maulmaolmawl/BQ76920_ActiveBal/MAIN_BQ_INDUCTOR_REV/Board.png

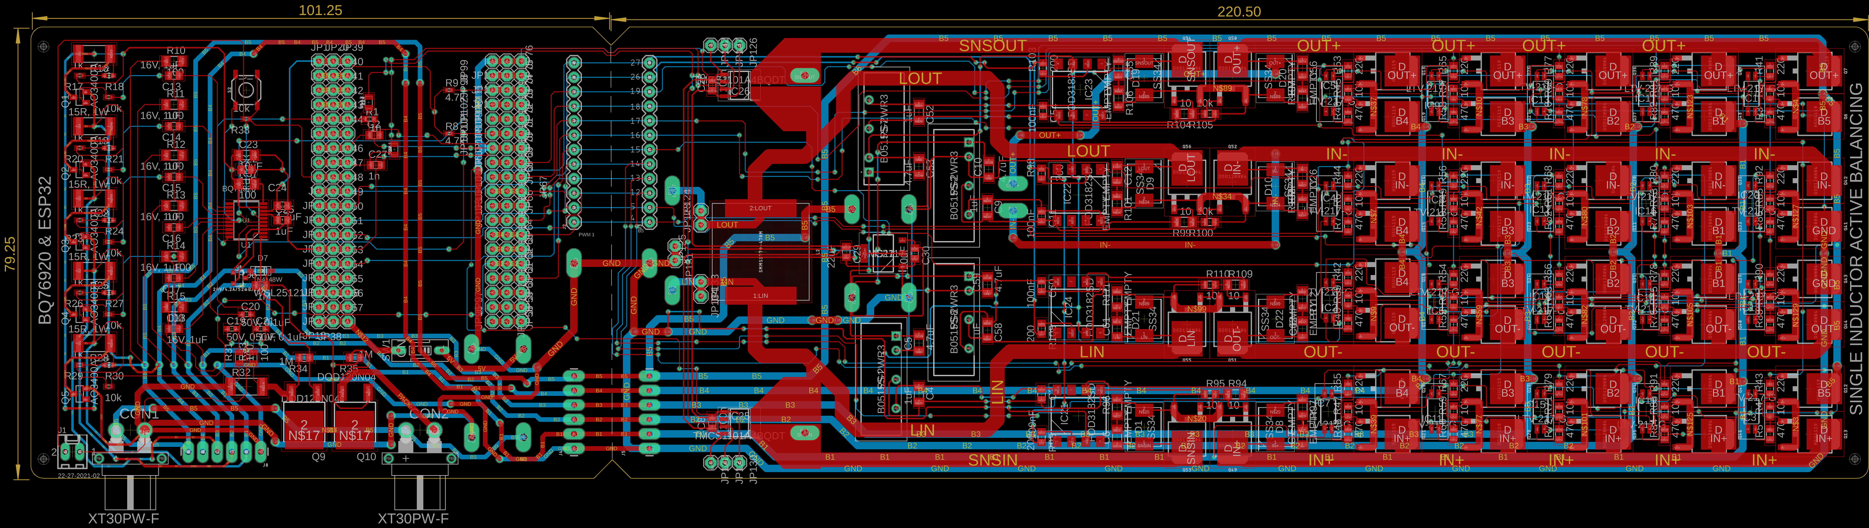
MAIN_BQ_INDUCTOR_REV/Board.png
