maulmaolmawl/BQ76920_ActiveBal/MAIN_BQ_INDUCTOR_REV/Skema.png

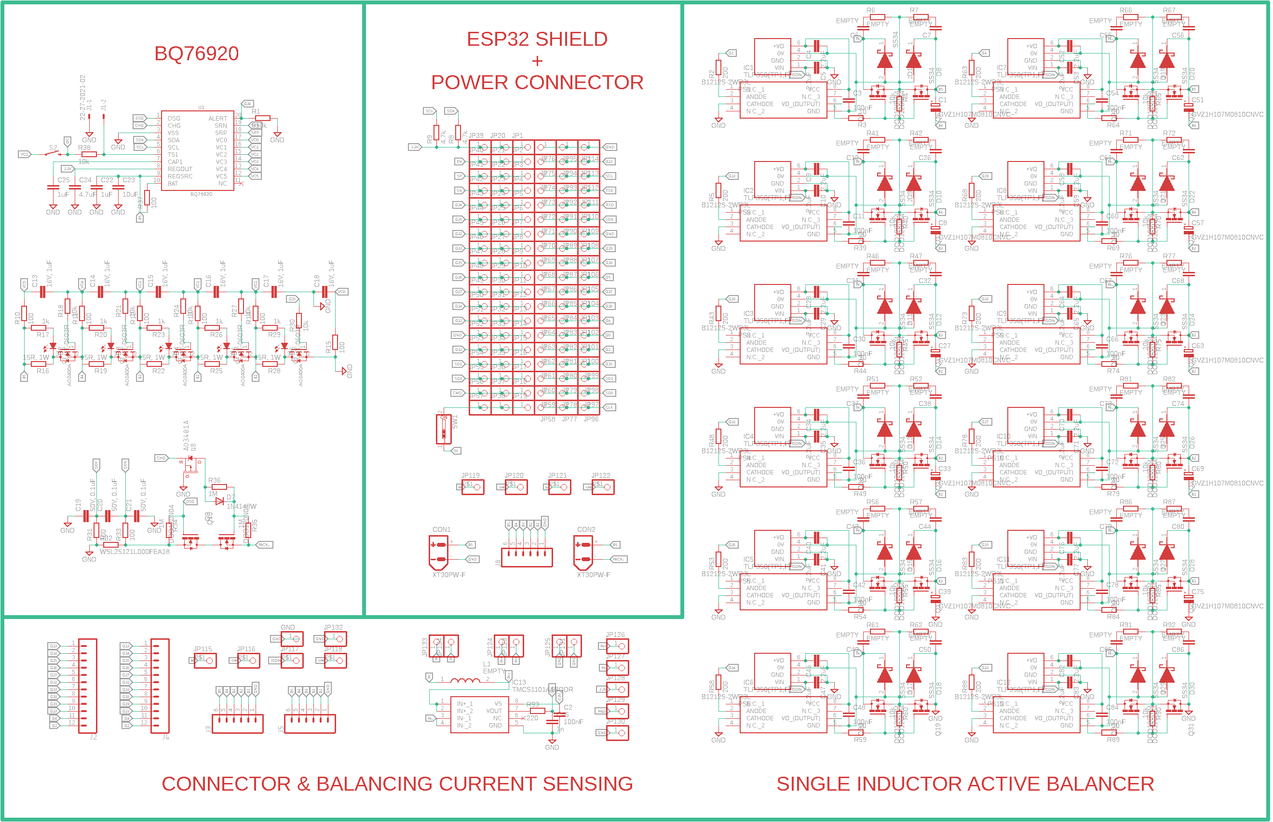
MAIN_BQ_INDUCTOR_REV/Skema.png
