maulmaolmawl/BQ76920_ActiveBal/MAIN_BQ_INDUCTOR_REV/Skematik2.png

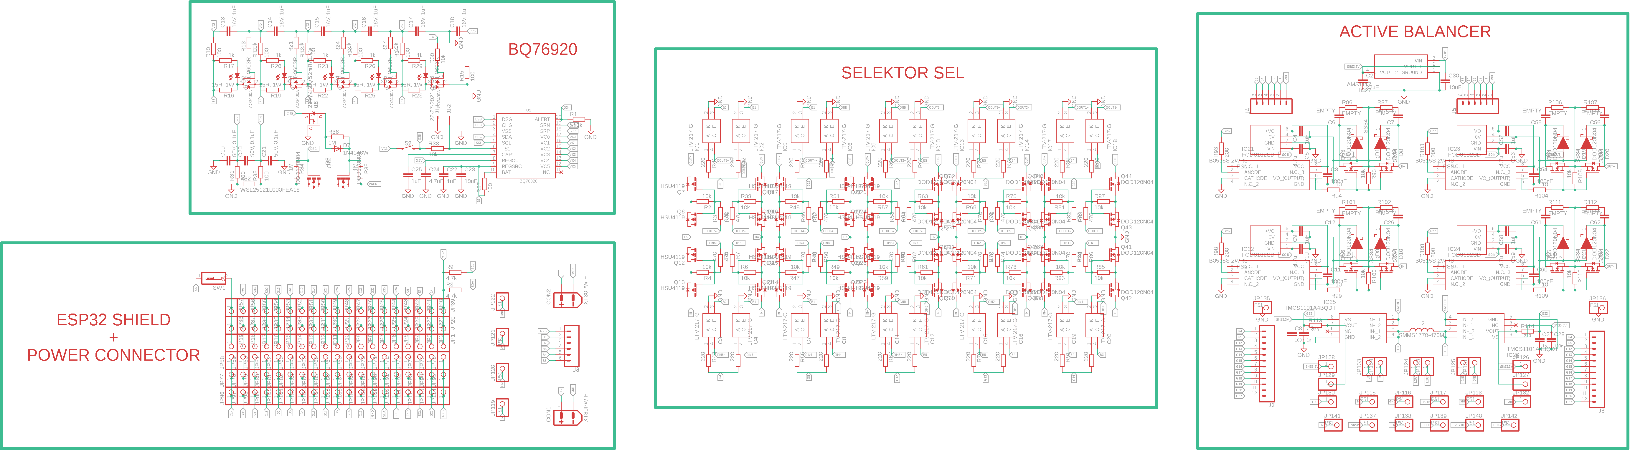
MAIN_BQ_INDUCTOR_REV/Skematik2.png
