maulmaolmawl/BQ76920_ActiveBal/MAIN_BQ_INDUCTOR_REV/Skematikk.png

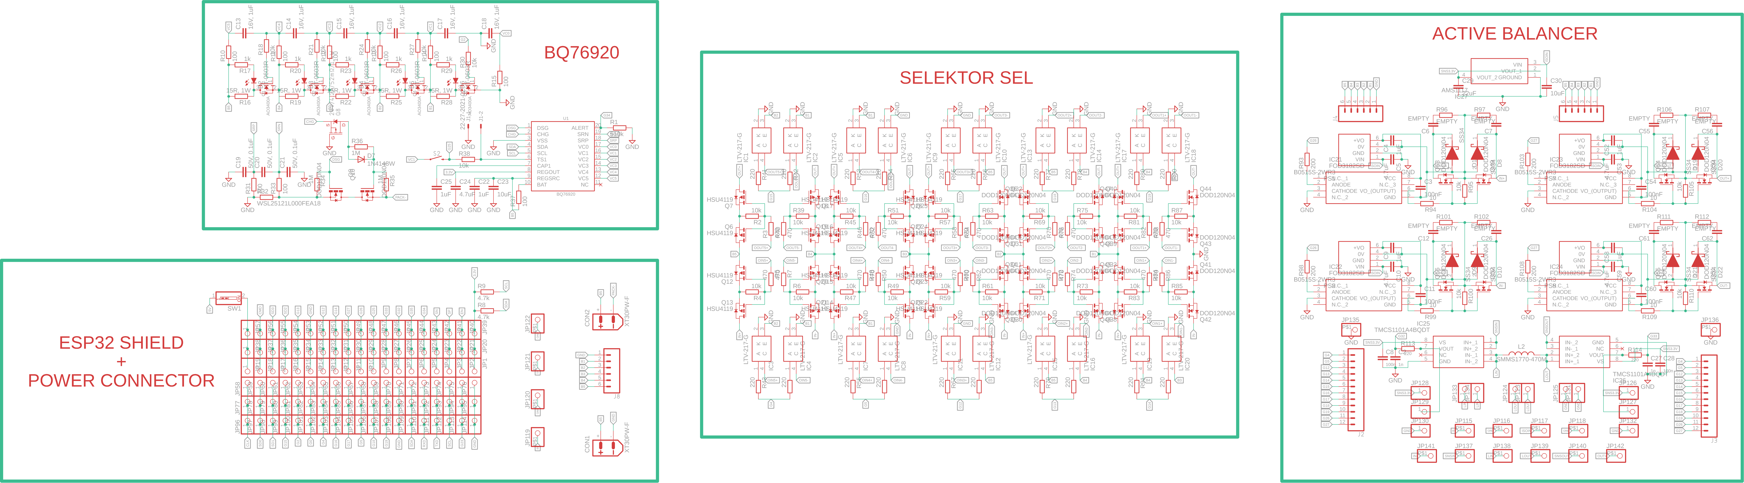
MAIN_BQ_INDUCTOR_REV/Skematikk.png
