maulmaolmawl/BQ76920_ActiveBal/MAIN_BQ_INDUCTOR_REV/MAIN_BQ_INDUCTOR_REV.brd

## EAGLE design MAIN_BQ_INDUCTOR_REV/MAIN_BQ_INDUCTOR_REV.brd (2026-06-24)

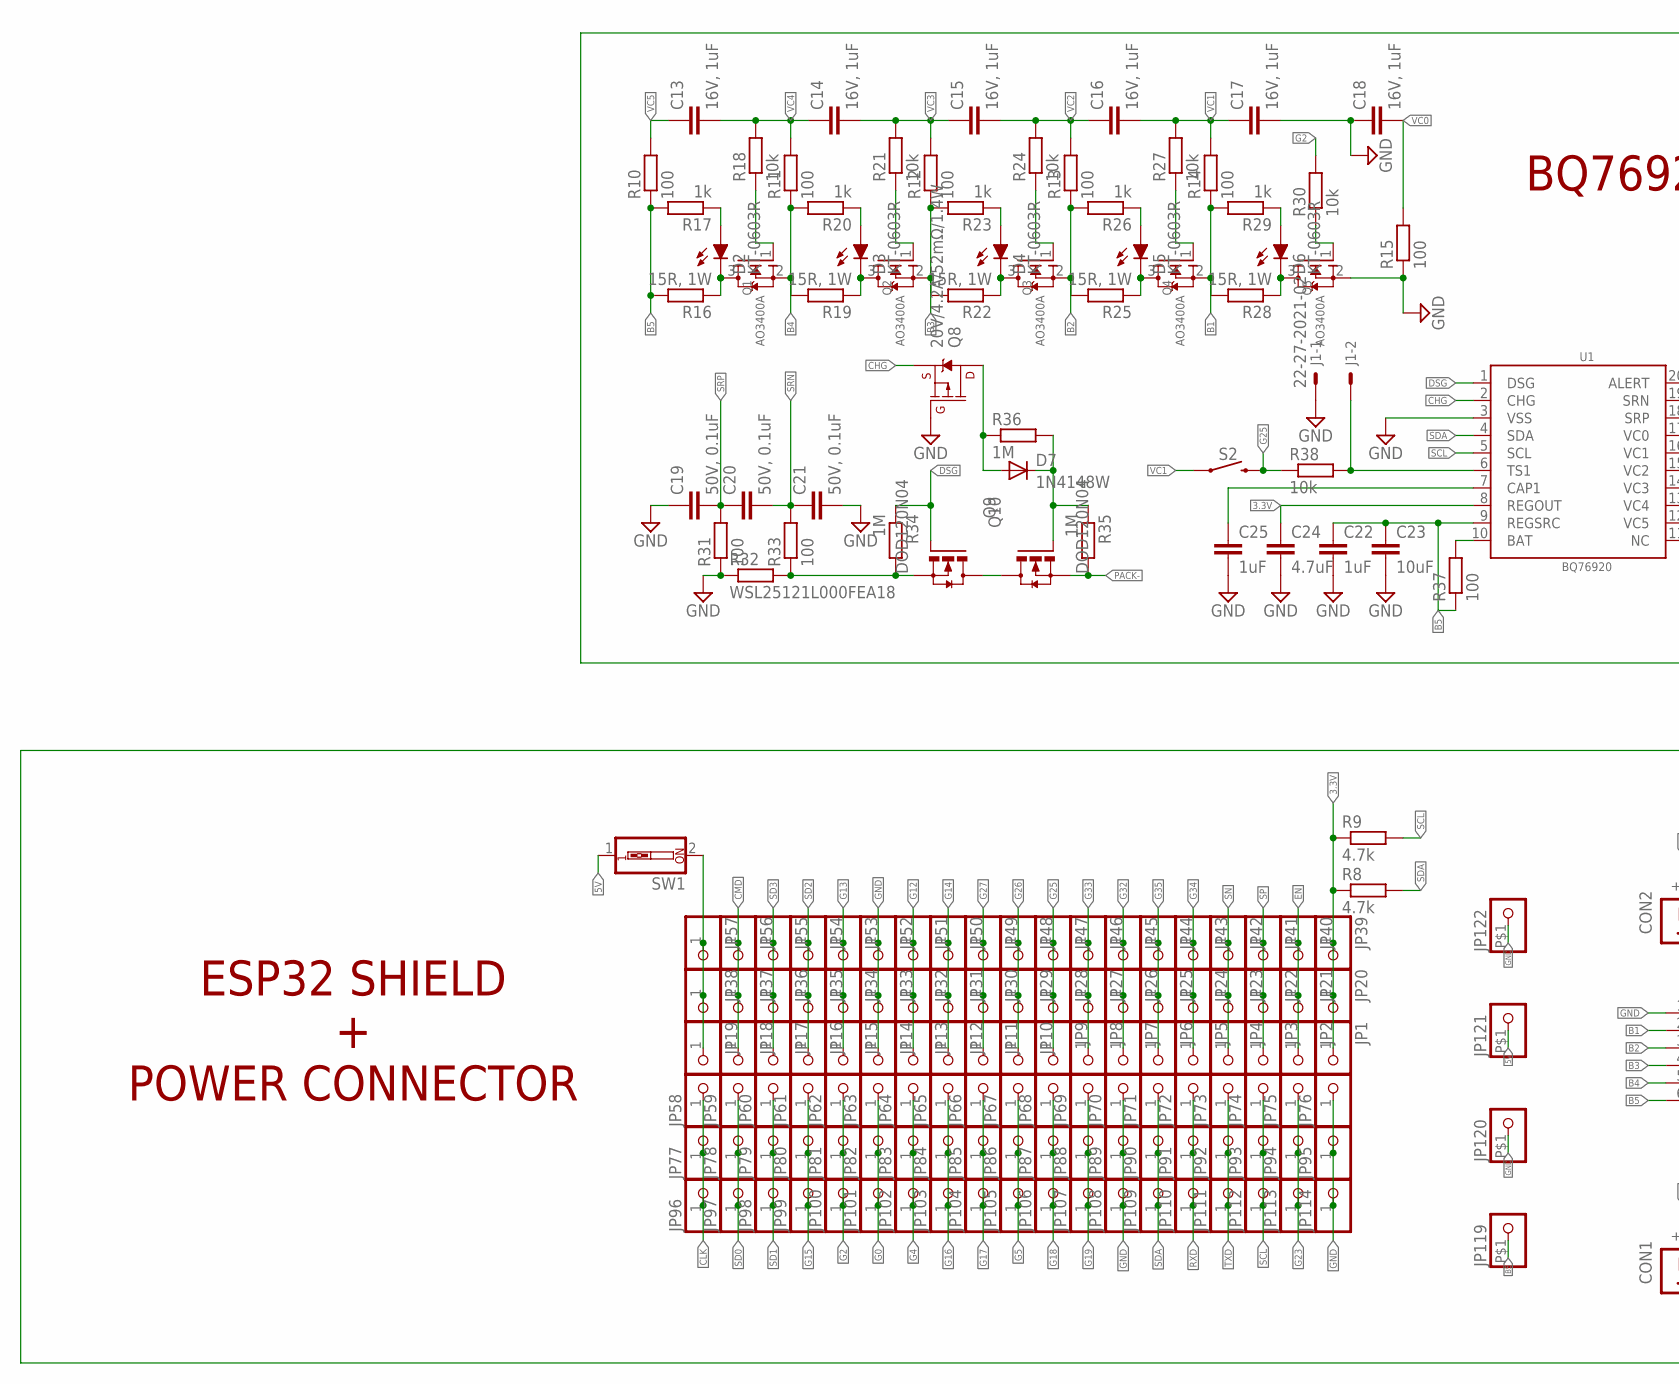
[picture p5: schematic MAIN_BQ_INDUCTOR_REV.sch, part in row 1, column 1]

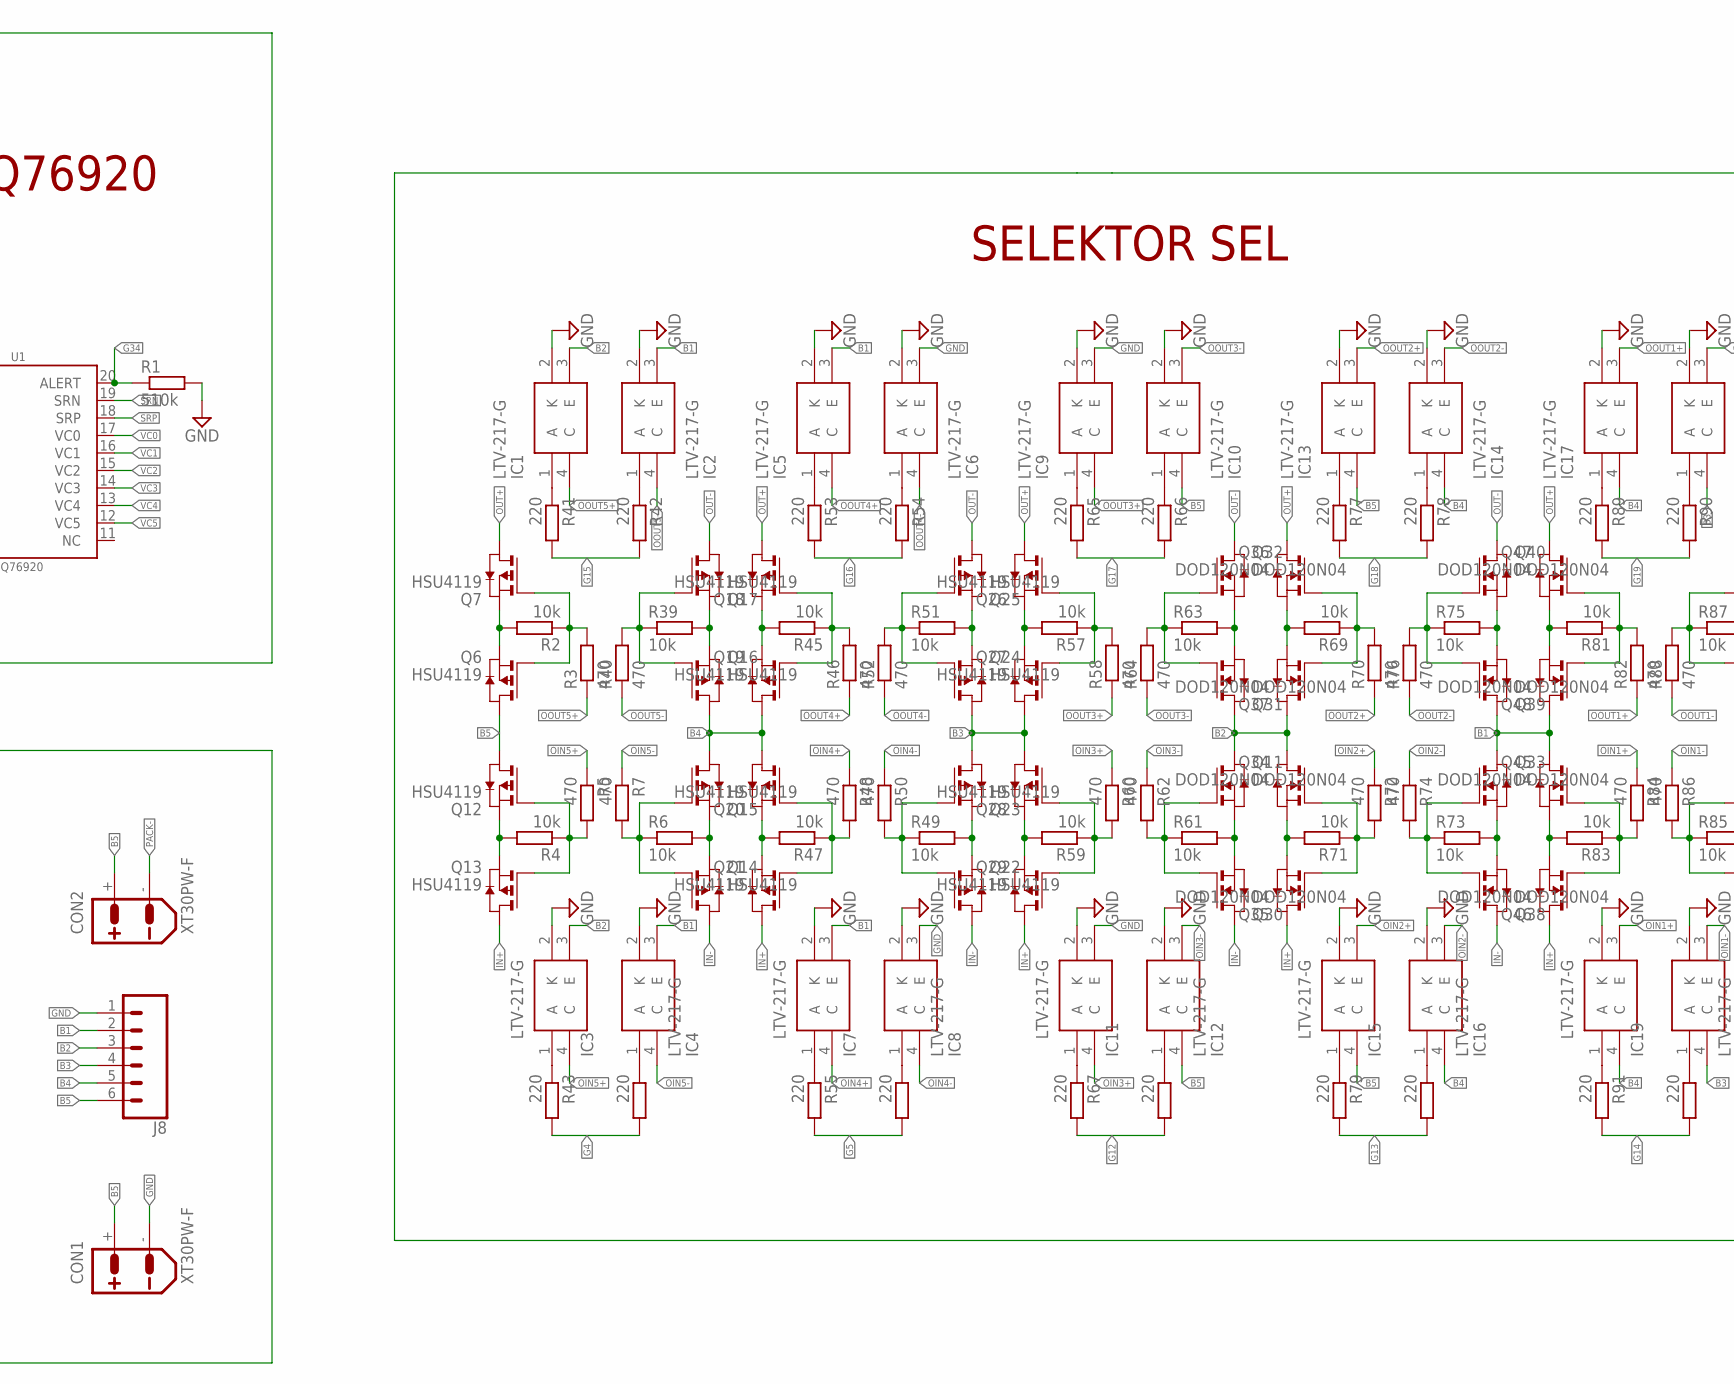
[picture p6: schematic MAIN_BQ_INDUCTOR_REV.sch, part in row 1, column 2]

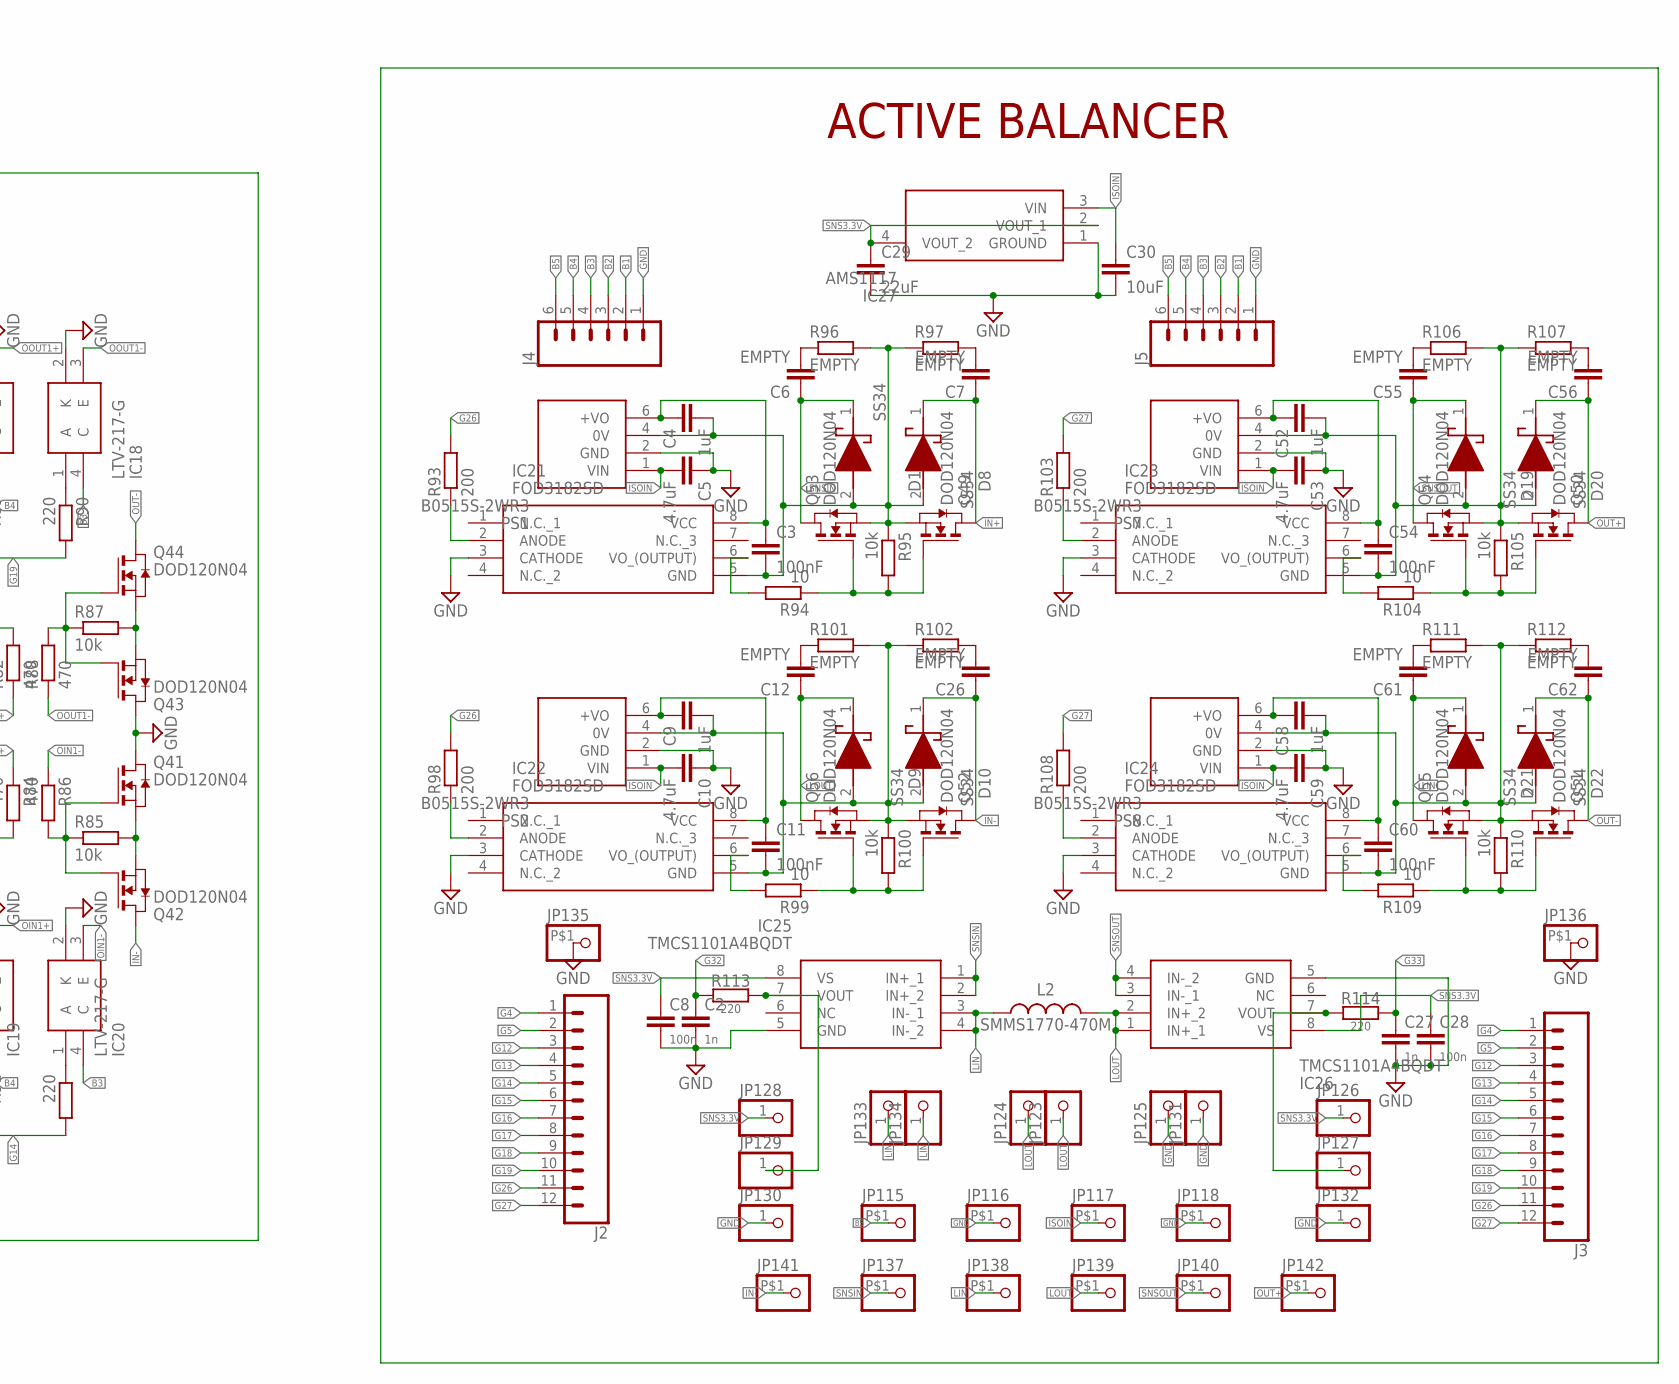
[picture p7: schematic MAIN_BQ_INDUCTOR_REV.sch, part in row 1, column 3]

Parts:
C2, C27: 1n; C0805
C3, C11, C54, C60: 100nF; C0805
C4, C9, C52, C58: 1uF; C1206
C5, C10, C53, C59: 4.7uF; C1206
C6, C7, C12, C26, C55, C56, C61, C62: EMPTY; C1206
C8, C28: 100n; C0805
C13, C14, C15, C16, C17, C18: 16V, 1uF; C0805
C19, C20, C21: 50V, 0.1uF; C0603
C22, C25: 1uF; C0805
C23: 10uF; C1206
C24: 4.7uF; C0805
C29: 22uF; C0805
C30: 10uF; C0805
CON1, CON2: XT30PW-F
D1, D8, D9, D10, D19, D20, D21, D22: SS34; DIOM6959X262N
D2, D3, D4, D5, D6: KT-0603R; LED_CHIP-LED0603MP
D7: 1N4148W; SOD-123
IC1, IC2, IC3, IC4, IC5, IC6, IC7, IC8, IC9, IC10, IC11, IC12, IC13, IC14, IC15, IC16, IC17, IC18, IC19, IC20: LTV-217-G; LTV217G
IC21, IC22, IC23, IC24: FOD3182SD; SOP254P1000X400-8N
IC25, IC26: TMCS1101A4BQDT; SOIC127P600X175-8N
IC27: AMS1117; SOT229P700X180-4N
J1: 22-27-2021-02; 6410-02
J2, J3: CONN_12; 1X12
J4, J5, J8: CONN_06LONGPADS; 1X06_LONGPADS
JP1, JP2, JP3, JP4, JP5, JP6, JP7, JP8, JP9, JP10, JP11, JP12, JP13, JP14, JP15, JP16, JP17, JP18, JP19, JP20, JP21, JP22, JP23, JP24, JP25, JP26, JP27, JP28, JP29, JP30, JP31, JP32, JP33, JP34, JP35, JP36, JP37, JP38, JP39, JP40, JP41, JP42, JP43, JP44, JP45, JP46, JP47, JP48, JP49, JP50, JP51, JP52, JP53, JP54, JP55, JP56, JP57, JP58, JP59, JP60, JP61, JP62, JP63, JP64, JP65, JP66, JP67, JP68, JP69, JP70, JP71, JP72, JP73, JP74, JP75, JP76, JP77, JP78, JP79, JP80, JP81, JP82, JP83, JP84, JP85, JP86, JP87, JP88, JP89, JP90, JP91, JP92, JP93, JP94, JP95, JP96, JP97, JP98, JP99, JP100, JP101, JP102, JP103, JP104, JP105, JP106, JP107, JP108, JP109, JP110, JP111, JP112, JP113, JP114, JP123, JP124, JP125, JP126, JP127, JP128, JP129, JP130, JP131, JP132, JP133, JP134: PINHD-1X1; 1X01
JP115, JP116, JP117, JP118, JP119, JP120, JP121, JP122, JP135, JP136, JP137, JP138, JP139, JP140, JP141, JP142: PINHD-1X1-BIGPOGO; 1X1-BIGPOGO
L2: SMMS1770-470M; PA4344-17X17
PS1, PS2, PS7, PS8: B0515S-2WR3; B1212S2WR3
Q1, Q2, Q3, Q4, Q5: AO3400A; SOT23
Q6, Q7, Q12, Q13, Q14, Q15, Q16, Q17, Q18, Q19, Q20, Q21, Q22, Q23, Q24, Q25, Q26, Q27, Q28, Q29: HSU4119; TO252
Q8: 20V/4.2A/52mΩ/1.4W; SOT23-3
Q9, Q10: DOD120N04; DPAK
Q11, Q30, Q31, Q32, Q33, Q34, Q35, Q36, Q37, Q38, Q39, Q40, Q41, Q42, Q43, Q44, Q45, Q46, Q47, Q48, Q49, Q50, Q51, Q52, Q53, Q54, Q55, Q56: DOD120N04; TO252
R1: 510k; R0603
R2, R4, R6, R39, R45, R47, R49, R51, R57, R59, R61, R63, R69, R71, R73, R75, R81, R83, R85, R87, R95, R100, R105, R110: 10k; R0805
R3, R5, R7, R40, R46, R48, R50, R52, R58, R60, R62, R64, R70, R72, R74, R76, R82, R84, R86, R88: 470; R0805
R8, R9: 4.7k; R0402
R10, R11, R12, R13, R14, R15, R37: 100; R1206
R16, R19, R22, R25, R28: 15R, 1W; R2512
R17, R20, R23, R26, R29: 1k; R0402
R18, R21, R24, R27, R30, R38: 10k; R0402
R31, R33: 100; R0805
R32: WSL25121L000FEA18; R2512
R34, R35, R36: 1M; R0805
R41, R42, R43, R44, R53, R54, R55, R56, R65, R66, R67, R68, R77, R78, R79, R80, R89, R90, R91, R92, R113, R114: 220; R0805
R93, R98, R103, R108: 200; R0805
R94, R99, R104, R109: 10; R1206
R96, R97, R101, R102, R106, R107, R111, R112: EMPTY; R1206
S2: MOMENTARY-SWITCH-SPST-SMD-5.2-TALL-REDUNDANT; TACTILE_SWITCH_SMD_5.2MM
SW1: SW_DIP-1; EDG-01
U1: BQ76920; TSSOP-20_4.4X6.5MM_PITCH0.65MM

Connections:
3.3V: C24.1, JP1.1, JP20.1, JP39.1, R8.1, R9.1, U1.8 (REGOUT)
5V: JP121.P$1, SW1.1
B1: IC2.3 (E), IC4.3 (E), IC5.3 (E), IC7.3 (E), J4.2, J5.2, J8.2, Q4.2 (S), Q33.D, Q39.D, Q45.D, Q48.D, R14.1, R28.2, R29.2
B2: IC1.3 (E), IC3.3 (E), J4.3, J5.3, J8.3, Q3.2 (S), Q11.D, Q31.D, Q34.D, Q37.D, R13.1, R25.2, R26.2
B3: IC18.4 (C), IC20.4 (C), J4.4, J5.4, J8.4, Q2.2 (S), Q23.D, Q24.D, Q27.D, Q28.D, R12.1, R22.2, R23.2
B4: IC14.4 (C), IC16.4 (C), IC17.4 (C), IC19.4 (C), J4.5, J5.5, J8.5, Q1.2 (S), Q15.D, Q16.D, Q19.D, Q20.D, R11.1, R19.2, R20.2
B5: C22.1, C23.1, CON1.+, CON2.+, IC10.4 (C), IC12.4 (C), IC13.4 (C), IC15.4 (C), J4.6, J5.6, J8.6, JP115.P$1, JP119.P$1, Q6.D, Q12.D, R10.1, R16.2, R17.2, R37.1, U1.9 (REGSRC)
CHG: Q8.2 (S), U1.2 (CHG)
CLK: JP58.1, JP77.1, JP96.1
CMD: JP18.1, JP37.1, JP56.1
DSG: Q9.1 (G), R34.1, U1.1 (DSG)
EN: JP2.1, JP21.1, JP40.1
G0: JP63.1, JP82.1, JP101.1
G2: JP62.1, JP81.1, JP100.1, R30.2
G4: J2.1, J3.1, JP64.1, JP83.1, JP102.1, R43.2, R44.2
G5: J2.2, J3.2, JP67.1, JP86.1, JP105.1, R55.2, R56.2
G12: J2.3, J3.3, JP13.1, JP32.1, JP51.1, R67.2, R68.2
G13: J2.4, J3.4, JP15.1, JP34.1, JP53.1, R79.2, R80.2
G14: J2.5, J3.5, JP12.1, JP31.1, JP50.1, R91.2, R92.2
G15: J2.6, J3.6, JP61.1, JP80.1, JP99.1, R41.2, R42.2
G16: J2.7, J3.7, JP65.1, JP84.1, JP103.1, R53.2, R54.2
G17: J2.8, J3.8, JP66.1, JP85.1, JP104.1, R65.2, R66.2
G18: J2.9, J3.9, JP68.1, JP87.1, JP106.1, R77.2, R78.2
G19: J2.10, J3.10, JP69.1, JP88.1, JP107.1, R89.2, R90.2
G23: JP75.1, JP94.1, JP113.1
G25: JP9.1, JP28.1, JP47.1, R38.1, S2.3 (2), S2.4 (2)
G26: J2.11, J3.11, JP10.1, JP29.1, JP48.1, R93.2, R98.2
G27: J2.12, J3.12, JP11.1, JP30.1, JP49.1, R103.2, R108.2
G32: C2.1, JP7.1, JP26.1, JP45.1, R113.1
G33: C27.1, JP8.1, JP27.1, JP46.1, R114.2
G34: JP5.1, JP24.1, JP43.1, R1.1, U1.20 (ALERT)
G35: JP6.1, JP25.1, JP44.1
GND: C2.2, C5.1, C8.2, C10.1, C17.2, C18.1, C19.1, C21.2, C22.2, C23.2, C24.2, C25.2, C27.2, C28.2, C29.2, C30.2, C53.1, C59.1, CON1.-, IC1.2 (K), IC2.2 (K), IC3.2 (K), IC4.2 (K), IC5.2 (K), IC6.2 (K), IC6.3 (E), IC7.2 (K), IC8.2 (K), IC8.3 (E), IC9.2 (K), IC9.3 (E), IC10.2 (K), IC11.2 (K), IC11.3 (E), IC12.2 (K), IC13.2 (K), IC14.2 (K), IC15.2 (K), IC16.2 (K), IC17.2 (K), IC18.2 (K), IC19.2 (K), IC20.2 (K), IC21.3 (CATHODE), IC22.3 (CATHODE), IC23.3 (CATHODE), IC24.3 (CATHODE), IC25.5 (GND), IC26.5 (GND), IC27.1 (GROUND), J1.1, J4.1, J5.1, J8.1, JP14.1, JP33.1, JP52.1, JP70.1, JP76.1, JP89.1, JP95.1, JP108.1, JP114.1, JP116.P$1, JP118.P$1, JP120.P$1, JP122.P$1, JP125.1, JP130.1, JP131.1, JP132.1, JP135.P$1, JP136.P$1, PS1.2 (GND), PS2.2 (GND), PS7.2 (GND), PS8.2 (GND), Q5.2 (S), Q8.1 (G), Q41.D, Q43.D, R1.2, R15.1, R31.1, R32.1, U1.3 (VSS)
IN+: C7.1, D8.1 (K), Q13.D, Q21.D, Q29.D, Q35.D, Q46.D, Q49.D
IN-: C26.1, D10.1 (K), JP141.P$1, Q14.D, Q22.D, Q30.D, Q38.D, Q42.D, Q52.D
ISOIN: C5.2, C10.2, C30.1, C53.2, C59.2, IC27.3 (VIN), JP117.P$1, PS1.1 (VIN), PS2.1 (VIN), PS7.1 (VIN), PS8.1 (VIN)
LIN: C61.1, D21.1 (K), IC25.3 (IN-_1), IC25.4 (IN-_2), JP133.1, JP134.1, JP138.P$1, L2.1, Q55.D
LOUT: C12.1, D9.1 (K), IC26.1 (IN+_1), IC26.2 (IN+_2), JP123.1, JP124.1, JP139.P$1, L2.2, Q56.D
unnamed: Q12.G, Q13.G, R4.1, R5.2
unnamed: Q6.G, Q7.G, R2.1, R3.2
unnamed: Q12.S, Q13.S, R4.2
unnamed: Q6.S, Q7.S, R2.2
unnamed: Q26.G, Q27.G, R57.1, R58.2
unnamed: Q14.G, Q15.G, R6.1, R7.2
unnamed: Q14.S, Q15.S, R6.2
unnamed: Q16.G, Q17.G, R39.1, R40.2
unnamed: Q16.S, Q17.S, R39.2
unnamed: Q26.S, Q27.S, R57.2
unnamed: IC21.6 (VO_(OUTPUT)), R94.2
unnamed: JP19.1, JP38.1, JP57.1, SW1.2
unnamed: D7.A, Q8.3 (D), R36.1
unnamed: Q9.3 (S), R32.2, R33.1, R34.2
unnamed: C3.1, C4.1, IC21.8 (VCC), PS1.6 (+VO)
unnamed: Q9.2 (D), Q10.2 (D)
unnamed: R37.2, U1.10 (BAT)
unnamed: IC21.2 (ANODE), R93.1
unnamed: C3.2, C4.2, D1.2 (A), D8.2 (A), IC21.5 (GND), PS1.4 (0V), Q49.S, Q53.S, R95.1, R96.2, R97.1
unnamed: Q49.G, Q53.G, R94.1, R95.2
unnamed: C6.2, R96.1
unnamed: IC1.1 (A), R41.1
unnamed: IC2.1 (A), R42.1
unnamed: C7.2, R97.2
unnamed: IC22.6 (VO_(OUTPUT)), R99.2
unnamed: D7.C, Q10.1 (G), R35.1, R36.2
unnamed: IC3.1 (A), R43.1
unnamed: C9.1, C11.1, IC22.8 (VCC), PS2.6 (+VO)
unnamed: IC4.1 (A), R44.1
unnamed: IC22.2 (ANODE), R98.1
unnamed: J1.2, R38.2, U1.6 (TS1)
unnamed: C25.1, U1.7 (CAP1)
unnamed: C9.2, C11.2, D9.2 (A), D10.2 (A), IC22.5 (GND), PS2.4 (0V), Q52.S, Q56.S, R100.1, R101.2, R102.1
unnamed: Q52.G, Q56.G, R99.1, R100.2
unnamed: Q18.G, Q19.G, R45.1, R46.2
unnamed: Q18.S, Q19.S, R45.2
unnamed: Q20.G, Q21.G, R47.1, R48.2
unnamed: Q20.S, Q21.S, R47.2
unnamed: Q28.G, Q29.G, R59.1, R60.2
unnamed: Q22.G, Q23.G, R49.1, R50.2
unnamed: Q22.S, Q23.S, R49.2
unnamed: D2.C, Q1.3 (D), R16.1
unnamed: D2.A, R17.1
unnamed: Q1.1 (G), R18.1
unnamed: D3.C, Q2.3 (D), R19.1
unnamed: D3.A, R20.1
unnamed: Q2.1 (G), R21.1
unnamed: D4.C, Q3.3 (D), R22.1
unnamed: D4.A, R23.1
unnamed: Q3.1 (G), R24.1
unnamed: D5.C, Q4.3 (D), R25.1
unnamed: D5.A, R26.1
unnamed: Q4.1 (G), R27.1
unnamed: D6.C, Q5.3 (D), R28.1
unnamed: D6.A, R29.1
unnamed: Q5.1 (G), R30.1
unnamed: Q24.G, Q25.G, R51.1, R52.2
unnamed: Q24.S, Q25.S, R51.2
unnamed: Q36.G, Q37.G, R69.1, R70.2
unnamed: C12.2, R101.1
unnamed: C26.2, R102.2
unnamed: IC5.1 (A), R53.1
unnamed: C52.1, C54.1, IC23.8 (VCC), PS7.6 (+VO)
unnamed: IC6.1 (A), R54.1
unnamed: IC23.2 (ANODE), R103.1
unnamed: IC7.1 (A), R55.1
unnamed: IC8.1 (A), R56.1
unnamed: Q50.G, Q54.G, R104.1, R105.2
unnamed: Q51.G, Q55.G, R109.1, R110.2
unnamed: C61.2, R111.1
unnamed: C62.2, R112.2
unnamed: IC25.7 (VOUT), JP129.1, R113.2
unnamed: IC26.7 (VOUT), JP127.1, R114.1
unnamed: Q28.S, Q29.S, R59.2
unnamed: Q36.S, Q37.S, R69.2
unnamed: Q11.G, Q30.G, R61.1, R62.2
unnamed: Q11.S, Q30.S, R61.2
unnamed: Q31.G, Q32.G, R63.1, R64.2
unnamed: Q31.S, Q32.S, R63.2
unnamed: Q47.G, Q48.G, R81.1, R82.2
unnamed: IC23.6 (VO_(OUTPUT)), R104.2
unnamed: IC9.1 (A), R65.1
unnamed: IC10.1 (A), R66.1
unnamed: C52.2, C54.2, D19.2 (A), D20.2 (A), IC23.5 (GND), PS7.4 (0V), Q50.S, Q54.S, R105.1, R106.2, R107.1
unnamed: IC11.1 (A), R67.1
unnamed: IC12.1 (A), R68.1
unnamed: C55.2, R106.1
unnamed: C56.2, R107.2
unnamed: IC24.6 (VO_(OUTPUT)), R109.2
unnamed: C58.1, C60.1, IC24.8 (VCC), PS8.6 (+VO)
unnamed: IC24.2 (ANODE), R108.1
unnamed: C58.2, C60.2, D21.2 (A), D22.2 (A), IC24.5 (GND), PS8.4 (0V), Q51.S, Q55.S, R110.1, R111.2, R112.1
unnamed: Q34.G, Q35.G, R71.1, R72.2
unnamed: Q34.S, Q35.S, R71.2
unnamed: Q33.G, Q38.G, R73.1, R74.2
unnamed: Q33.S, Q38.S, R73.2
unnamed: Q39.G, Q40.G, R75.1, R76.2
unnamed: Q39.S, Q40.S, R75.2
unnamed: IC13.1 (A), R77.1
unnamed: IC14.1 (A), R78.1
unnamed: IC15.1 (A), R79.1
unnamed: IC16.1 (A), R80.1
unnamed: Q47.S, Q48.S, R81.2
unnamed: Q45.G, Q46.G, R83.1, R84.2
unnamed: Q45.S, Q46.S, R83.2
unnamed: Q41.G, Q42.G, R85.1, R86.2
unnamed: Q41.S, Q42.S, R85.2
unnamed: Q43.G, Q44.G, R87.1, R88.2
unnamed: Q43.S, Q44.S, R87.2
unnamed: IC17.1 (A), R89.1
unnamed: IC18.1 (A), R90.1
unnamed: IC19.1 (A), R91.1
unnamed: IC20.1 (A), R92.1
OIN1+: IC19.3 (E), R84.1
OIN1-: IC20.3 (E), R86.1
OIN2+: IC15.3 (E), R72.1
OIN2-: IC16.3 (E), R74.1
OIN3+: IC11.4 (C), R60.1
OIN3-: IC12.3 (E), R62.1
OIN4+: IC7.4 (C), R48.1
OIN4-: IC8.4 (C), R50.1
OIN5+: IC3.4 (C), R5.1
OIN5-: IC4.4 (C), R7.1
OOUT1+: IC17.3 (E), R82.1
OOUT1-: IC18.3 (E), R88.1
OOUT2+: IC13.3 (E), R70.1
OOUT2-: IC14.3 (E), R76.1
OOUT3+: IC9.4 (C), R58.1
OOUT3-: IC10.3 (E), R64.1
OOUT4+: IC5.4 (C), R46.1
OOUT4-: IC6.4 (C), R52.1
OOUT5+: IC1.4 (C), R3.1
OOUT5-: IC2.4 (C), R40.1
OUT+: C56.1, D20.1 (K), JP142.P$1, Q7.D, Q18.D, Q26.D, Q36.D, Q47.D, Q50.D
OUT-: C62.1, D22.1 (K), Q17.D, Q25.D, Q32.D, Q40.D, Q44.D, Q51.D
PACK-: CON2.-, Q10.3 (S), R35.2
RXD: JP72.1, JP91.1, JP110.1
SCL: JP74.1, JP93.1, JP112.1, R9.2, U1.5 (SCL)
SD0: JP59.1, JP78.1, JP97.1
SD1: JP60.1, JP79.1, JP98.1
SD2: JP16.1, JP35.1, JP54.1
SD3: JP17.1, JP36.1, JP55.1
SDA: JP71.1, JP90.1, JP109.1, R8.2, U1.4 (SDA)
SN: JP4.1, JP23.1, JP42.1
SNS3.3V: C8.1, C28.1, C29.1, IC25.8 (VS), IC26.8 (VS), IC27.2 (VOUT_1), IC27.4 (VOUT_2), JP126.1, JP128.1
SNSIN: C6.1, D1.1 (K), IC25.1 (IN+_1), IC25.2 (IN+_2), JP137.P$1, Q53.D
SNSOUT: C55.1, D19.1 (K), IC26.3 (IN-_1), IC26.4 (IN-_2), JP140.P$1, Q54.D
SP: JP3.1, JP22.1, JP41.1
SRN: C20.2, C21.1, R33.2, U1.19 (SRN)
SRP: C19.2, C20.1, R31.2, U1.18 (SRP)
TXD: JP73.1, JP92.1, JP111.1
VC0: C18.2, R15.2, U1.17 (VC0)
VC1: C16.2, C17.1, R14.2, R27.2, S2.1, S2.2 (1), U1.16 (VC1)
VC2: C15.2, C16.1, R13.2, R24.2, U1.15 (VC2)
VC3: C14.2, C15.1, R12.2, R21.2, U1.14 (VC3)
VC4: C13.2, C14.1, R11.2, R18.2, U1.13 (VC4)
VC5: C13.1, R10.2, U1.12 (VC5)

Notes on the sheet:
ESP32 SHIELD + POWER CONNECTOR
BQ76920
SELEKTOR SEL
ACTIVE BALANCER

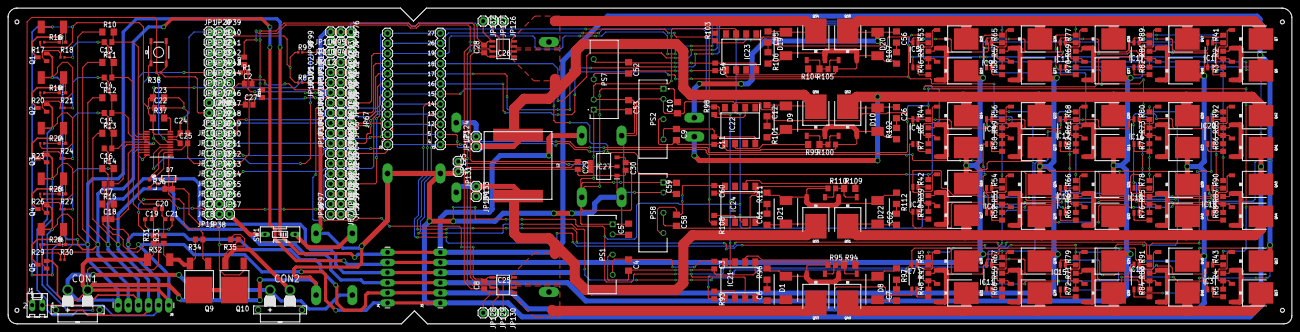
[picture p8: board MAIN_BQ_INDUCTOR_REV.brd from above]

Board: 2 copper layers, 322.2 x 79.2 mm, 408 parts (1 on the bottom side), 195 nets.
