maulmaolmawl/BQ76920_ActiveBal/bq769x0_PWM_Auto_MAIN/bq769x0.cpp

#include <Arduino.h>
#include <Wire.h>     // I2C/TWI (for Battery Management IC)
#include <math.h>     // log for thermistor calculation

#include "bq769x0.h"
#include "registers.h"

// for the ISR to know the bq769x0 instance
bq769x0* bq769x0::instancePointer = 0;


#if BQ769X0_DEBUG

const char *byte2char(int x)
{
    static char b[9];
    b[0] = '\0';

    int z;
    for (z = 128; z > 0; z >>= 1)
    {
        strcat(b, ((x & z) == z) ? "1" : "0");
    }

    return b;
}

#endif

//----------------------------------------------------------------------------

bq769x0::bq769x0(byte bqType, int bqI2CAddress)
{
  type = bqType;
  I2CAddress = bqI2CAddress;
  
  if (type == bq76920) {
    numberOfCells = 5;
  }
  else if (type == bq76930) {
    numberOfCells = 10;  
  }
  else {
    numberOfCells = 15;
  }
  
  // prevent errors if someone reduced MAX_NUMBER_OF_CELLS accidentally
  if (numberOfCells > MAX_NUMBER_OF_CELLS) {
    numberOfCells = MAX_NUMBER_OF_CELLS;
  }
}


//-----------------------------------------------------------------------------

int bq769x0::begin(byte alertPin, byte bootPin)
{
  Wire.begin();        // join I2C bus

  // initialize variables
  for (byte i = 0; i < numberOfCells; i++) {
    cellVoltages[i] = 0;
  }
  
  // Boot IC if pin is defined (else: manual boot via push button has to be 
  // done before calling this method)
  if (bootPin >= 0)
  {
    //pinMode(bootPin, OUTPUT);
    //digitalWrite(bootPin, HIGH);
    //delay(5);   // wait 5 ms for device to receive boot signal (datasheet: max. 2 ms)
    pinMode(bootPin, INPUT);     // don't disturb temperature measurement
    delay(10);  // wait for device to boot up completely (datasheet: max. 10 ms)
  }
 
  // test communication
  writeRegister(CC_CFG, 0x19);       // should be set to 0x19 according to datasheet
  if (readRegister(CC_CFG) == 0x19)
  {
    // initial settings for bq769x0
    writeRegister(SYS_CTRL1, B00011000);  // switch external thermistor and ADC on
    writeRegister(SYS_CTRL2, B01000000);  // switch CC_EN on

    // attach ALERT interrupt to this instance
    instancePointer = this;
    attachInterrupt(digitalPinToInterrupt(alertPin), bq769x0::alertISR, RISING);

    // get ADC offset and gain
    adcOffset = (signed int) readRegister(ADCOFFSET);  // convert from 2's complement
    adcGain = 365 + (((readRegister(ADCGAIN1) & B00001100) << 1) | 
      ((readRegister(ADCGAIN2) & B11100000) >> 5)); // uV/LSB
    
    return 0;
  }
  else
  {
    #if BQ769X0_DEBUG
    Serial.println("BMS communication error");
    #endif
    return 1;
  }
}

//----------------------------------------------------------------------------
// Fast function to check whether BMS has an error
// (returns 0 if everything is OK)

int bq769x0::checkStatus()
{
   Serial.print("errorStatus: ");
   Serial.println(errorStatus);
  if (alertInterruptFlag == false && errorStatus == 0) {
    return 0;
  }
  else {
    
    regSYS_STAT_t sys_stat;
    sys_stat.regByte = readRegister(SYS_STAT);

    if (sys_stat.bits.CC_READY == 1) {
      //Serial.println("Interrupt: CC ready");
      updateCurrent(true);  // automatically clears CC ready flag	
    }
    
    // Serious error occured
    if (sys_stat.regByte & B00111111)
    {
      if (alertInterruptFlag == true) {
        secSinceErrorCounter = 0;
      }
      errorStatus = sys_stat.regByte;
      
      int secSinceInterrupt = (millis() - interruptTimestamp) / 1000;
      
      // check for overrun of millis() or very slow running program
      if (abs((long)(secSinceInterrupt - secSinceErrorCounter)) > 2) {
        secSinceErrorCounter = secSinceInterrupt;
      }
      
      // called only once per second
      if (secSinceInterrupt >= secSinceErrorCounter)
      {
        if (sys_stat.regByte & B00100000) { // XR error
          // datasheet recommendation: try to clear after waiting a few seconds
          if (secSinceErrorCounter % 3 == 0) {
            #if BQ769X0_DEBUG
            Serial.println(F("Attempting to clear XR error"));
            #endif
            writeRegister(SYS_STAT, B00100000);
          }
        }
        if (sys_stat.regByte & B00010000) { // Alert error
          if (secSinceErrorCounter % 10 == 0) {
            #if BQ769X0_DEBUG
            Serial.println(F("Attempting to clear Alert error"));
            #endif
            writeRegister(SYS_STAT, B00010000);
          }
        }
        if (sys_stat.regByte & B00001000) { // UV error
          updateVoltages();
          if (cellVoltages[idCellMinVoltage] > minCellVoltage) {
            #if BQ769X0_DEBUG
            Serial.println(F("Attempting to clear UV error"));
            #endif
            writeRegister(SYS_STAT, B00001000);
          }
        }
        if (sys_stat.regByte & B00000100) { // OV error
          updateVoltages();
          if (cellVoltages[idCellMaxVoltage] < maxCellVoltage) {
            #if BQ769X0_DEBUG
            Serial.println(F("Attempting to clear OV error"));
            #endif
            writeRegister(SYS_STAT, B00000100);
          }
        }
        if (sys_stat.regByte & B00000010) { // SCD
          if (secSinceErrorCounter % 60 == 0) {
            #if BQ769X0_DEBUG
            Serial.println(F("Attempting to clear SCD error"));
            #endif
            writeRegister(SYS_STAT, B00000010);
          }
        }
        if (sys_stat.regByte & B00000001) { // OCD
          if (secSinceErrorCounter % 60 == 0) {
            #if BQ769X0_DEBUG
            Serial.println(F("Attempting to clear OCD error"));
            #endif
            writeRegister(SYS_STAT, B00000001);
          }
        }
        
        secSinceErrorCounter++;
      }
    }
    else {
      errorStatus = 0;
    }
    
    return errorStatus;

  }

}

//----------------------------------------------------------------------------
// should be called at least once every 250 ms to get correct coulomb counting

void bq769x0::update()
{
  updateCurrent();  // will only read new current value if alert was triggered
  updateVoltages();
  updateTemperatures();
  updateBalancingSwitches();
  //enableDischarging();
  //enableCharging();
}

//----------------------------------------------------------------------------
// puts BMS IC into SHIP mode (i.e. switched off)

void bq769x0::shutdown()
{
  writeRegister(SYS_CTRL1, 0x0);
  writeRegister(SYS_CTRL1, 0x1);
  writeRegister(SYS_CTRL1, 0x2);
}

//----------------------------------------------------------------------------

bool bq769x0::enableCharging()
{
  if (checkStatus() == 0) // &&
   // cellVoltages[idCellMaxVoltage] < maxCellVoltage &&
    //temperatures[0]  < maxCellTempCharge &&
    //temperatures[0] > minCellTempCharge)
  {
    byte sys_ctrl2;
    sys_ctrl2 = readRegister(SYS_CTRL2);
    writeRegister(SYS_CTRL2, sys_ctrl2 | B00000001);  // switch CHG on
    #if BQ769X0_DEBUG
    Serial.println("Enabling CHG FET");
    #endif
    return true;
  }
  else {
    return false;
  }
}

//----------------------------------------------------------------------------

bool bq769x0::enableDischarging()
{
  if (checkStatus() == 0)// &&
    //cellVoltages[idCellMinVoltage] > minCellVoltage &&
    //temperatures[0] < maxCellTempDischarge &&
    //temperatures[0] > minCellTempDischarge)
  {
    byte sys_ctrl2;
    sys_ctrl2 = readRegister(SYS_CTRL2);
    writeRegister(SYS_CTRL2, sys_ctrl2 | B00000010);  // switch DSG on
    #if BQ769X0_DEBUG
    Serial.println("Enabling DSG FET");
    #endif
    return true;
  }
  else {
    return false;
  }
}

// ... existing code ...

void bq769x0::disableCharging()
{
  byte sys_ctrl2;
  sys_ctrl2 = readRegister(SYS_CTRL2);
  writeRegister(SYS_CTRL2, sys_ctrl2 & ~B00000001);  
  #if BQ769X0_DEBUG
  Serial.println("Disabling CHG FET");
  #endif
}

void bq769x0::disableDischarging()
{
  byte sys_ctrl2;
  sys_ctrl2 = readRegister(SYS_CTRL2);
  writeRegister(SYS_CTRL2, sys_ctrl2 & ~B00000010);  
  #if BQ769X0_DEBUG
  Serial.println("Disabling DSG FET");
  #endif
}

//----------------------------------------------------------------------------


void bq769x0::enableAutoBalancing(void)
{
  autoBalancingEnabled = true;
}


//----------------------------------------------------------------------------

void bq769x0::setBalancingThresholds(int idleTime_min, int absVoltage_mV, byte voltageDifference_mV)
{
  balancingMinIdleTime_s = idleTime_min * 60;
  balancingMinCellVoltage_mV = absVoltage_mV;
  balancingMaxVoltageDifference_mV = voltageDifference_mV;
}

//----------------------------------------------------------------------------
// sets balancing registers if balancing is allowed 
// (sufficient idle time + voltage)

byte bq769x0::updateBalancingSwitches(void)
{
  return 0;
  long idleSeconds = (millis() - idleTimestamp) / 1000;
  byte numberOfSections = numberOfCells/5;
  
  // check for millis() overflow
  if (idleSeconds < 0) {
    idleTimestamp = 0;
    idleSeconds = millis() / 1000;
  }
    
  // check if balancing allowed
  if (checkStatus() == 0 &&
    idleSeconds >= balancingMinIdleTime_s && 
    cellVoltages[idCellMaxVoltage] > balancingMinCellVoltage_mV &&
    (cellVoltages[idCellMaxVoltage] - cellVoltages[idCellMinVoltage]) > balancingMaxVoltageDifference_mV)
  {
    balancingActive = true;
    //Serial.println("Balancing enabled!");
    
    regCELLBAL_t cellbal;
    byte balancingFlags;
    byte balancingFlagsTarget;
    
    for (int section = 0; section < numberOfSections; section++)
    {
      balancingFlags = 0;
      for (int i = 0; i < 5; i++)
      {
        if ((cellVoltages[section*5 + i] - cellVoltages[idCellMinVoltage]) > balancingMaxVoltageDifference_mV) {
          
          // try to enable balancing of current cell
          balancingFlagsTarget = balancingFlags | (1 << i);

          // check if attempting to balance adjacent cells
          bool adjacentCellCollision = 
            ((balancingFlagsTarget << 1) & balancingFlags) ||
            ((balancingFlags << 1) & balancingFlagsTarget);
            
          if (adjacentCellCollision == false) {
            balancingFlags = balancingFlagsTarget;
          }          
        }
      }
      Serial.print("Setting CELLBAL");
      Serial.print(section+1);
      Serial.print(" register to: ");
      Serial.println(byte2char(balancingFlags));
      
      // set balancing register for this section
      writeRegister(CELLBAL1+section, balancingFlags);
    }
  }
  else if (balancingActive == true)
  {  
    // clear all CELLBAL registers
    for (int section = 0; section < numberOfSections; section++)
    {
      Serial.print("Clearing Register CELLBAL");
      Serial.println(section+1);
      writeRegister(CELLBAL1+section, 0x0);
    }
    
    balancingActive = false;
  }
}

void bq769x0::setShuntResistorValue(int res_mOhm)
{
  shuntResistorValue_mOhm = res_mOhm;
}

void bq769x0::setThermistorBetaValue(int beta_K)
{
  thermistorBetaValue = beta_K;
}

void bq769x0::setTemperatureLimits(int minDischarge_degC, int maxDischarge_degC, 
  int minCharge_degC, int maxCharge_degC)
{
  // Temperature limits (°C/10)
  minCellTempDischarge = minDischarge_degC * 10;
  maxCellTempDischarge = maxDischarge_degC * 10;
  minCellTempCharge = minCharge_degC * 10;
  maxCellTempCharge = maxCharge_degC * 10;  
}

void bq769x0::setIdleCurrentThreshold(int current_mA)
{
  idleCurrentThreshold = current_mA;
}


//----------------------------------------------------------------------------

long bq769x0::setShortCircuitProtection(long current_mA, int delay_us)
{
  regPROTECT1_t protect1;
  
  // only RSNS = 1 considered
  protect1.bits.RSNS = 1;

  protect1.bits.SCD_THRESH = 0;
  for (int i = sizeof(SCD_threshold_setting)-1; i > 0; i--) {
    if (current_mA * shuntResistorValue_mOhm / 1000 >= SCD_threshold_setting[i]) {
      protect1.bits.SCD_THRESH = i;
      break;
    }
  }
  
  protect1.bits.SCD_DELAY = 0;
  for (int i = sizeof(SCD_delay_setting)-1; i > 0; i--) {
    if (delay_us >= SCD_delay_setting[i]) {
      protect1.bits.SCD_DELAY = i;
      break;
    }
  }
  
  writeRegister(PROTECT1, protect1.regByte);
  
  // returns the actual current threshold value
  return (long)SCD_threshold_setting[protect1.bits.SCD_THRESH] * 1000 / 
    shuntResistorValue_mOhm;
}

//----------------------------------------------------------------------------

long bq769x0::setOvercurrentChargeProtection(long current_mA, int delay_ms)
{
  return 0; // Return a default value to prevent a crash
  // ToDo: Software protection for charge overcurrent
}

//----------------------------------------------------------------------------

long bq769x0::setOvercurrentDischargeProtection(long current_mA, int delay_ms)
{
  regPROTECT2_t protect2;
  
  // Remark: RSNS must be set to 1 in PROTECT1 register

  protect2.bits.OCD_THRESH = 0;
  for (int i = sizeof(OCD_threshold_setting)-1; i > 0; i--) {
    if (current_mA * shuntResistorValue_mOhm / 1000 >= OCD_threshold_setting[i]) {
      protect2.bits.OCD_THRESH = i;
      break;
    }
  }
  
  protect2.bits.OCD_DELAY = 0;
  for (int i = sizeof(OCD_delay_setting)-1; i > 0; i--) {
    if (delay_ms >= OCD_delay_setting[i]) {
      protect2.bits.OCD_DELAY = i;
      break;
    }
  }
  
  writeRegister(PROTECT2, protect2.regByte);
 
  // returns the actual current threshold value
  return (long)OCD_threshold_setting[protect2.bits.OCD_THRESH] * 1000 / 
    shuntResistorValue_mOhm;
}


//----------------------------------------------------------------------------

int bq769x0::setCellUndervoltageProtection(int voltage_mV, int delay_s)
{
  regPROTECT3_t protect3;
  byte uv_trip = 0;
  
  minCellVoltage = voltage_mV;
  
  protect3.regByte = readRegister(PROTECT3);
  
  uv_trip = ((((long)voltage_mV - adcOffset) * 1000 / adcGain) >> 4) & 0x00FF;
  uv_trip += 1;   // always round up for lower cell voltage
  writeRegister(UV_TRIP, uv_trip);
  
  Serial.println(voltage_mV);
  Serial.println(uv_trip);

  protect3.bits.UV_DELAY = 0;
  for (int i = sizeof(UV_delay_setting)-1; i > 0; i--) {
    if (delay_s >= UV_delay_setting[i]) {
      protect3.bits.UV_DELAY = i;
      break;
    }
  }
  
  writeRegister(PROTECT3, protect3.regByte);
  
  // returns the actual current threshold value
  return ((long)1 << 12 | uv_trip << 4) * adcGain / 1000 + adcOffset;
}

//----------------------------------------------------------------------------

int bq769x0::setCellOvervoltageProtection(int voltage_mV, int delay_s)
{
  regPROTECT3_t protect3;
  byte ov_trip = 0;

  maxCellVoltage = voltage_mV;
  
  protect3.regByte = readRegister(PROTECT3);
  
  ov_trip = ((((long)voltage_mV - adcOffset) * 1000 / adcGain) >> 4) & 0x00FF;
  writeRegister(OV_TRIP, ov_trip);

  Serial.println(voltage_mV);
  Serial.println(ov_trip);
    
  protect3.bits.OV_DELAY = 0;
  for (int i = sizeof(OV_delay_setting)-1; i > 0; i--) {
    if (delay_s >= OV_delay_setting[i]) {
      protect3.bits.OV_DELAY = i;
      break;
    }
  }
  
  writeRegister(PROTECT3, protect3.regByte);
 
  // returns the actual current threshold value
  return ((long)1 << 13 | ov_trip << 4) * adcGain / 1000 + adcOffset;
}


//----------------------------------------------------------------------------

int bq769x0::getBatteryCurrent()
{
  return batCurrent;
}

//----------------------------------------------------------------------------

int bq769x0::getBatteryVoltage()
{
  return batVoltage;
}

//----------------------------------------------------------------------------

int bq769x0::getMaxCellVoltage()
{
  return cellVoltages[idCellMaxVoltage];
}

//----------------------------------------------------------------------------

int bq769x0::getCellVoltage(byte idCell)
{
  return cellVoltages[idCell-1];
}


//----------------------------------------------------------------------------

float bq769x0::getTemperatureDegC(byte channel)
{
  if (channel >= 1 && channel <= 3) {
    return (float)temperatures[channel-1] / 10.0;
  }
  else
    return -273.15;   // Error: Return absolute minimum temperature
}

//----------------------------------------------------------------------------

float bq769x0::getTemperatureDegF(byte channel)
{
  return getTemperatureDegC(channel) * 1.8 + 32;
}


//----------------------------------------------------------------------------

void bq769x0::updateTemperatures()
{
  float tmp = 0;
  int adcVal = 0;
  int vtsx = 0;
  unsigned long rts = 0;
  
  Wire.beginTransmission(I2CAddress);
  Wire.write(0x2C);
  Wire.endTransmission();
  
  if (Wire.requestFrom(I2CAddress, 2) == 2)
  {
    // calculate R_thermistor according to bq769x0 datasheet
    adcVal = ((Wire.read() & B00111111) << 8) | Wire.read();
    vtsx = adcVal * 0.382; // mV
    rts = 10000.0 * vtsx / (3300.0 - vtsx); // Ohm
        
    // Temperature calculation using Beta equation
    // - According to bq769x0 datasheet, only 10k thermistors should be used
    // - 25°C reference temperature for Beta equation assumed
    tmp = 1.0/(1.0/(273.15+25) + 1.0/thermistorBetaValue*log(rts/10000.0)); // K
    
    temperatures[0] = (tmp - 273.15) * 10.0;
  }
}


//----------------------------------------------------------------------------
// If ignoreCCReadFlag == true, the current is read independent of an interrupt
// indicating the availability of a new CC reading

// This is the final, corrected function for bq769x0.cpp
void bq769x0::updateCurrent(bool ignoreCCReadyFlag)
{
  regSYS_STAT_t sys_stat;
  sys_stat.regByte = readRegister(SYS_STAT);

  if (ignoreCCReadyFlag == true || sys_stat.bits.CC_READY == 1)
  {
    int cc_hi = readRegister(CC_HI_BYTE);
    int cc_lo = readRegister(CC_LO_BYTE);

    // THE FIX: Combine bytes and immediately cast to a 16-bit SIGNED integer (int16_t)
    // This correctly interprets 0xFFBE as -66 instead of 65470.
    int16_t adcVal = (int16_t)((cc_hi << 8) | cc_lo);

    // This calculation will now use the correctly signed value
    batCurrent = (long)((float)adcVal * 8.44F / (float)shuntResistorValue_mOhm);

    if (abs(batCurrent) > idleCurrentThreshold) {
      idleTimestamp = millis();
    }

    if (!(sys_stat.regByte & B00111111)) {
      alertInterruptFlag = false;
    }

    writeRegister(SYS_STAT, STAT_CC_READY);  // Clear CC ready flag
  }
}

//----------------------------------------------------------------------------
// reads all cell voltages to array cellVoltages[4] and updates batVoltage

void bq769x0::updateVoltages()
{
  long adcVal = 0;
  
  // read battery pack voltage
  adcVal = (readRegister(BAT_HI_BYTE) << 8) | readRegister(BAT_LO_BYTE);
  batVoltage = (4 * (long)adcGain * adcVal) / 1000 + (4 * adcOffset);
  
  // read cell voltages
  Wire.beginTransmission(I2CAddress);
  Wire.write(VC1_HI_BYTE);
  Wire.endTransmission();
  
  if (Wire.requestFrom(I2CAddress, 2 * numberOfCells) == 2 * numberOfCells)
  {
    idCellMaxVoltage = 0;
    idCellMinVoltage = 0;
    for (int i = 0; i < numberOfCells; i++)
    {
      adcVal = ((Wire.read() & B00111111) << 8) | Wire.read();
      cellVoltages[i] = adcVal * adcGain / 1000 + adcOffset;

      if (cellVoltages[i] > cellVoltages[idCellMaxVoltage]) {
        idCellMaxVoltage = i;
      }
      if (cellVoltages[i] < cellVoltages[idCellMinVoltage] && cellVoltages[i] > 500) {
        idCellMinVoltage = i;
      }
    }
  }
}

//----------------------------------------------------------------------------

void bq769x0::writeRegister(byte address, int data)
{
  Wire.beginTransmission(I2CAddress);
  Wire.write(address);
  Wire.write(data);
  Wire.endTransmission();
}

//----------------------------------------------------------------------------

int bq769x0::readRegister(byte address)
{  
  Wire.beginTransmission(I2CAddress);
  Wire.write(address);
  Wire.endTransmission();
  Wire.requestFrom(I2CAddress, 1);
  return Wire.read();
}

//----------------------------------------------------------------------------
// the actual ISR, called by static function alertISR()

void bq769x0::setAlertInterruptFlag()
{
  interruptTimestamp = millis();
  alertInterruptFlag = true;
}

//----------------------------------------------------------------------------
// The bq769x0 drives the ALERT pin high if the SYS_STAT register contains
// a new value (either new CC reading or an error)

void bq769x0::alertISR()
{
  if (instancePointer != 0)
  {
    instancePointer->setAlertInterruptFlag();
  }
}


#if BQ769X0_DEBUG

//----------------------------------------------------------------------------
// for debug purposes

void bq769x0::printRegisters()
{
  Serial.print(F("0x00 SYS_STAT:  "));
  Serial.println(byte2char(readRegister(SYS_STAT)));

  Serial.print(F("0x01 CELLBAL1:  "));
  Serial.println(byte2char(readRegister(CELLBAL1)));

  Serial.print(F("0x04 SYS_CTRL1: "));
  Serial.println(byte2char(readRegister(SYS_CTRL1)));
  
  Serial.print(F("0x05 SYS_CTRL2: "));
  Serial.println(byte2char(readRegister(SYS_CTRL2)));
  
  Serial.print(F("0x06 PROTECT1:  "));
  Serial.println(byte2char(readRegister(PROTECT1)));
  
  Serial.print(F("0x07 PROTECT2:  "));
  Serial.println(byte2char(readRegister(PROTECT2)));
  
  Serial.print(F("0x08 PROTECT3   "));
  Serial.println(byte2char(readRegister(PROTECT3)));
  
  Serial.print(F("0x09 OV_TRIP:   "));
  Serial.println(byte2char(readRegister(OV_TRIP)));
  
  Serial.print(F("0x0A UV_TRIP:   "));
  Serial.println(byte2char(readRegister(UV_TRIP)));
  
  Serial.print(F("0x0B CC_CFG:    "));
  Serial.println(byte2char(readRegister(CC_CFG)));

  Serial.print(F("0x32 CC_HI:     "));
  Serial.println(byte2char(readRegister(CC_HI_BYTE)));

  Serial.print(F("0x33 CC_LO:     "));
  Serial.println(byte2char(readRegister(CC_LO_BYTE)));
/*
  Serial.print(F("0x50 ADCGAIN1:  "));
  Serial.println(byte2char(readRegister(ADCGAIN1)));

  Serial.print(F("0x51 ADCOFFSET: "));
  Serial.println(byte2char(readRegister(ADCOFFSET)));

  Serial.print(F("0x59 ADCGAIN2:  "));
  Serial.println(byte2char(readRegister(ADCGAIN2)));
  */
}

#endif
