maulmaolmawl/BQ76920_ActiveBal/bq769x0_PWM_Auto_MAIN/bq769x0.h

/*
    bq769x0.h - Battery management system based on bq769x0 for Arduino
    Copyright (C) 2015  Martin Jäger (m.jaeger@posteo.de)

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
    You should have received a copy of the GNU Lesser General Public
    License along with this program. If not, see 
    <http://www.gnu.org/licenses/>.
*/

#ifndef BQ769X0_H
#define BQ769X0_H

#include <Arduino.h>
#include <Wire.h>

// can be reduced to save some memory if smaller ICs are used
#define MAX_NUMBER_OF_CELLS 15
#define MAX_NUMBER_OF_THERMISTORS 3
 
// IC type/size
#define bq76920 1
#define bq76930 2
#define bq76940 3

// output information to serial console for debugging
#define BQ769X0_DEBUG 1

class bq769x0 {

  public:
    void writeRegister(byte address, int data);
    // initialization, status update and shutdown
    bq769x0(byte bqType = bq76920, int bqI2CAddress = 0x18);
    int begin(byte alertPin, byte bootPin = -1);
    int checkStatus();  // returns 0 if everything is OK
		void update(void);
		void shutdown(void);

    // charging control
		bool enableCharging(void);
		void disableCharging(void);
		bool enableDischarging(void);
		void disableDischarging(void);
    
    // hardware settings
    void setShuntResistorValue(int res_mOhm);
    void setThermistorBetaValue(int beta_K);

    // limit settings (for battery protection)
    void setTemperatureLimits(int minDischarge_degC, int maxDischarge_degC, int minCharge_degC, int maxCharge_degC);    // °C
    long setShortCircuitProtection(long current_mA, int delay_us = 70);
    long setOvercurrentChargeProtection(long current_mA, int delay_ms = 8);
    long setOvercurrentDischargeProtection(long current_mA, int delay_ms = 8);
    int setCellUndervoltageProtection(int voltage_mV, int delay_s = 1);
    int setCellOvervoltageProtection(int voltage_mV, int delay_s = 1);

    // balancing settings
 		void setBalancingThresholds(int idleTime_min = 30, int absVoltage_mV = 3400, byte voltageDifference_mV = 20);
    void setIdleCurrentThreshold(int current_mA);

    // automatic balancing when battery is within balancing thresholds
		void enableAutoBalancing(void);
		void disableAutoBalancing(void);
    
		// battery status
		int  getBatteryCurrent(void);
		int  getBatteryVoltage(void);
		int  getCellVoltage(byte idCell);    // from 1 to 15
		int  getMinCellVoltage(void);
		int  getMaxCellVoltage(void);
		float getTemperatureDegC(byte channel = 1);
    float getTemperatureDegF(byte channel = 1);
		
    // interrupt handling (not to be called manually!)
		void setAlertInterruptFlag(void);

    int  readRegister(byte address);

#if BQ769X0_DEBUG
		void printRegisters(void);		
#endif
   
	private:
  
  // Variables
  
    int I2CAddress;
    byte type;

    byte shuntResistorValue_mOhm;
    int thermistorBetaValue = 3380;  // typical value for Semitec 103AT-5 thermistor

    // indicates if a new current reading or an error is available from BMS IC
		bool alertInterruptFlag = true;   // init with true to check and clear errors at start-up   
	
    int numberOfCells;
		int cellVoltages[MAX_NUMBER_OF_CELLS];          // mV
    byte idCellMaxVoltage;
    byte idCellMinVoltage;
		long batVoltage;                                // mV
		long batCurrent;                                // mA
		int temperatures[MAX_NUMBER_OF_THERMISTORS];    // °C/10

    // Current limits (mA)
    long maxChargeCurrent;
    long maxDischargeCurrent;
    int idleCurrentThreshold = 30; // mA
    
    // Temperature limits (°C/10)
    int minCellTempCharge;
    int minCellTempDischarge;
    int maxCellTempCharge;
    int maxCellTempDischarge;

    // Cell voltage limits (mV)
    int maxCellVoltage;
    int minCellVoltage;
    int balancingMinCellVoltage_mV;
    byte balancingMaxVoltageDifference_mV;
    
    int adcGain;    // uV/LSB
    int adcOffset;  // mV
    
    int errorStatus = 0;
    bool autoBalancingEnabled = false;
    bool balancingActive = false;
    int balancingMinIdleTime_s = 1800;    // default: 30 minutes
    unsigned long idleTimestamp = 0;
    
		unsigned int secSinceErrorCounter = 0;
		unsigned long interruptTimestamp = 0;

		static bq769x0* instancePointer;
  
  // Methods
  
		static void alertISR(void);
    
		void  updateVoltages(void);
		void  updateCurrent(bool ignoreCCReadyFlag = false);
		void  updateTemperatures(void);
    
    byte updateBalancingSwitches(void);
		
};

#endif // BQ769X0_H
