maulmaolmawl/BQ76920_ActiveBal/(notices)

Notices in the files:
bq769x0_PWM_Auto_MAIN/bq769x0.h:
This program is free software: you can redistribute it and/or modify
it under the terms of the GNU Lesser General Public License as
published by the Free Software Foundation, either version 3 of the
License, or (at your option) any later version.
parts and their libraries:
SparkFun-DiscreteSemi: Licensing: Creative Commons ShareAlike 4.0 International - https://creativecommons.org/licenses/by-sa/4.0
